kevinsantiagoacosta195/Tesis_FSO/README.md

# Tesis_FSO
sistema de comunicacion FSO (Free Space Optics) para la transmision de Sistemas de alerta temprana, usando paneles solares como fotodetectores, encargador de recibir la señal de comunicacion PWM y la alimentacion del sistema.
 Nota: informacion principal (Bitacora/bitacora.md)
