kevinsantiagoacosta195/Tesis_FSO/Simulaciones/Comparador LM393/Docs/LM393.md

# Simulacion Panel Solar
## Fecha: 15/01/2026
## Objetivo
simular y analizar el comportamiento del comparador LM393, permitiendo analaizar y comprobar su eficiencia para la detencion de pulsos de haz emitido por un laser
## Fundamento teorico
el primer principio teorico es el principio diferencial, su funcionamiento se basa en comparar si la señal de entrada es mas fuerte que el voltaje de referencia establecido en el potenciometro del modulo, del mismo modo esta diseñado para saltar de 0 a 1 permitiendo observar una figura totalmente cuadrada por lo cual no se verian esas "aletas de tiburon que se observaba en el serial plotter del arduino causadas por el rise time tan largo demorandose bastante tanto en subie como en bajr ocacionado por capacitancia o resistencias.

## Metodologia 
1. se Realiza una simulacion por medio de Proteus 8
2. se hace uso de un VPULSE, el cual funciona como la señal esperada por el panel solar
3. se realiza un sistema pasa altos entre un capacitor y una resustencia
4. de la resistencia del capacitor y la resistencia sale hacia el comparador LM393, que ingresa al pin 3.
5. utilizamos un potenciometro como voltaje de referencia
6. se energiza el chip
7. se hace uso de un osciloscopio para analizar las graficas

### Resultado
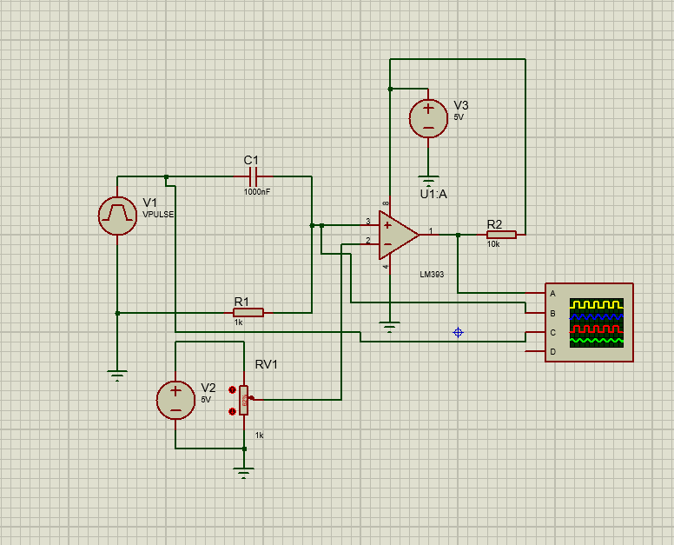
[picture p1: Simulaciones/Comparador LM393/Docs/Imagenes/Circuito comparador LM393.png]
CIRCUITO COMPLETO

se observa el circuito mencionamo anteriormente en la metodologia

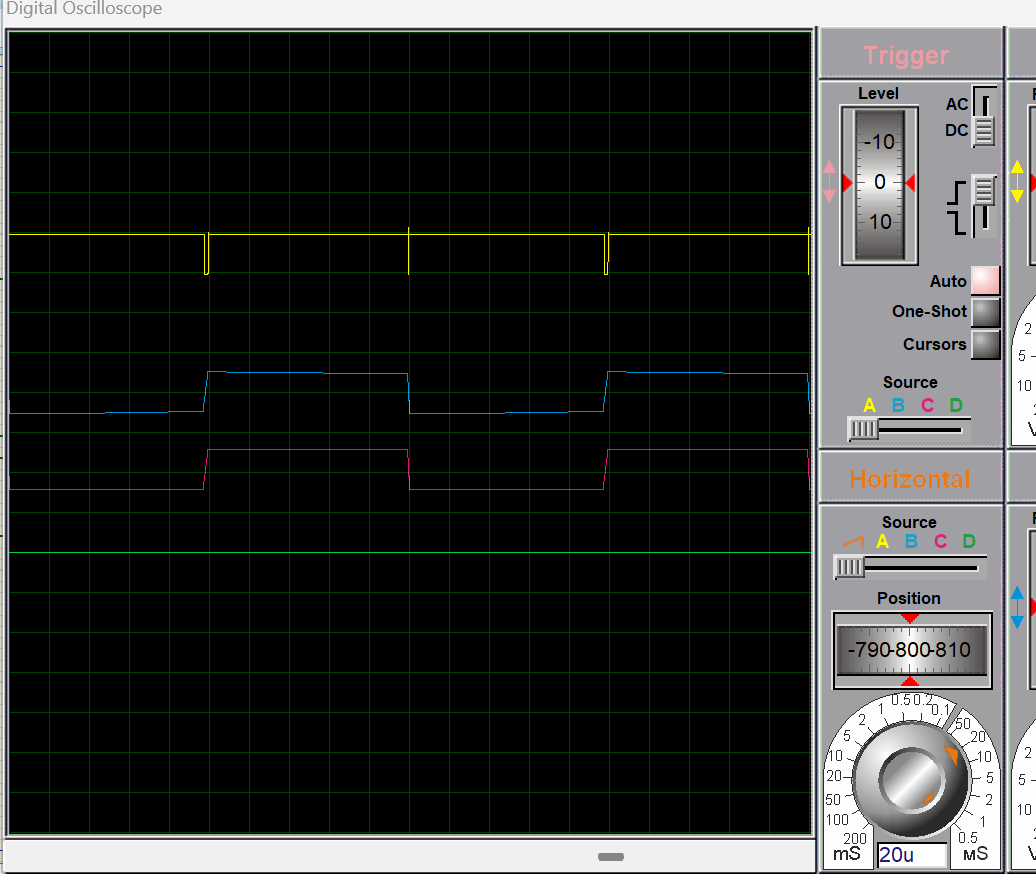
[picture p2: Simulaciones/Comparador LM393/Docs/Imagenes/RESULTADO 1.png]
ANALISIS SEÑAL 1

se observa que presenta aproximadamente el 95% del cycle duty, y unas pequeñas bajadas que son casi similares al Rise Time de la señal del nodo A (filtro pasa-alto), y del VPUlSE

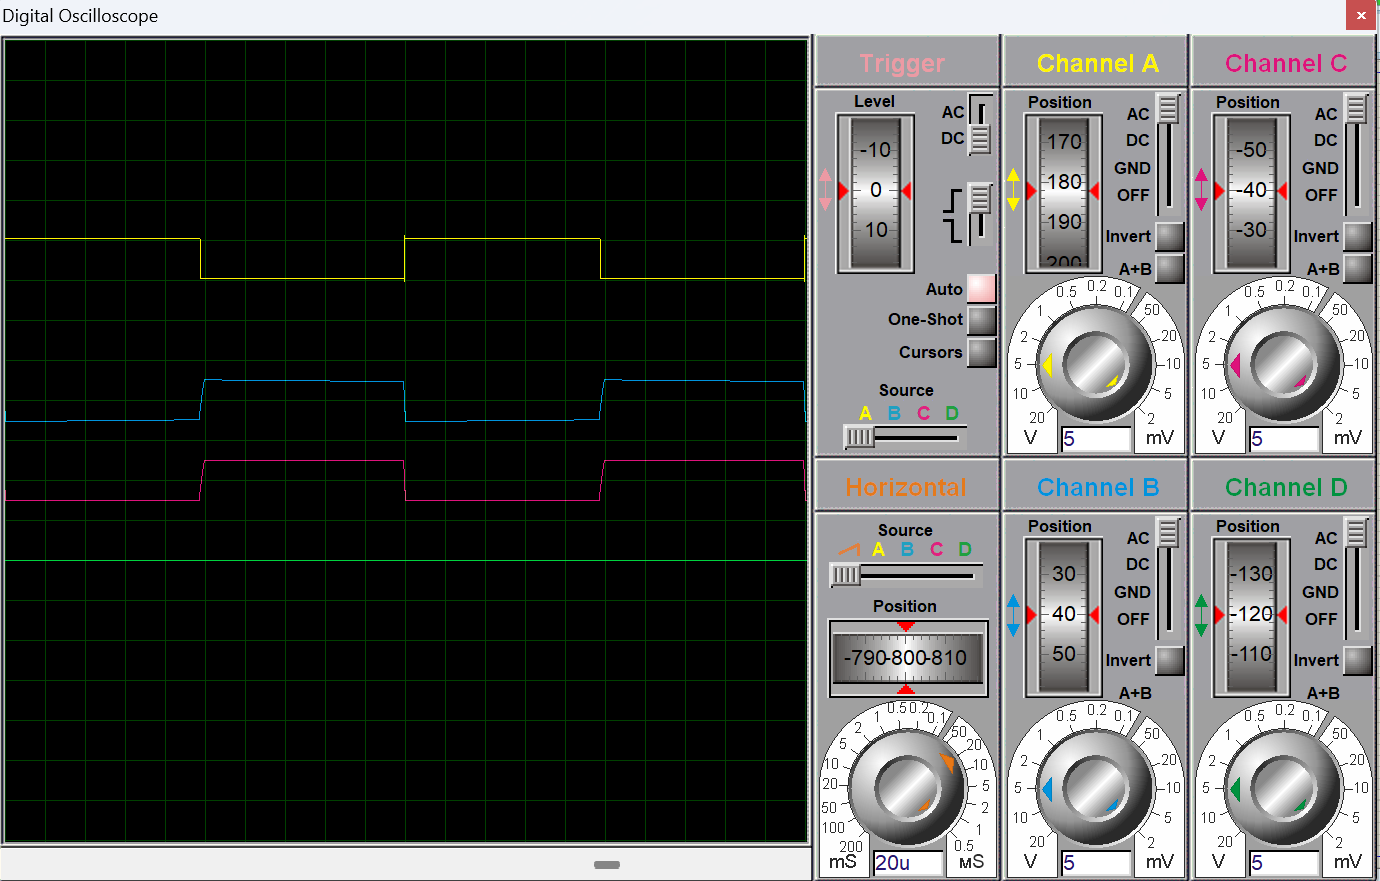
[picture p3: Simulaciones/Comparador LM393/Docs/Imagenes/RESULTADO 2.png]
ANALISIS SEÑAL 2

se observa que presenta el mismo ciclo y como se menciono en el fundamento las señales pwm son mucho mas claras, el arreglo se debo al ajuste del umbral del potenciometro
