kevinsantiagoacosta195/Tesis_FSO/Bitacora/Imagenes Prototipo/09_01_2026/PRUEBA LASER.jpeg

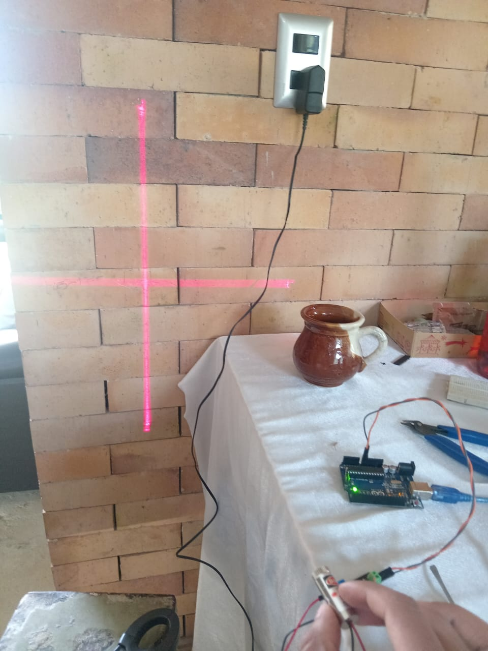
Bitacora/Imagenes Prototipo/09_01_2026/PRUEBA LASER.jpeg
