kevinsantiagoacosta195/Tesis_FSO/Bitacora/Imagenes Prototipo/11_01_2026/CIRCUITO ARREGLADO.jpeg

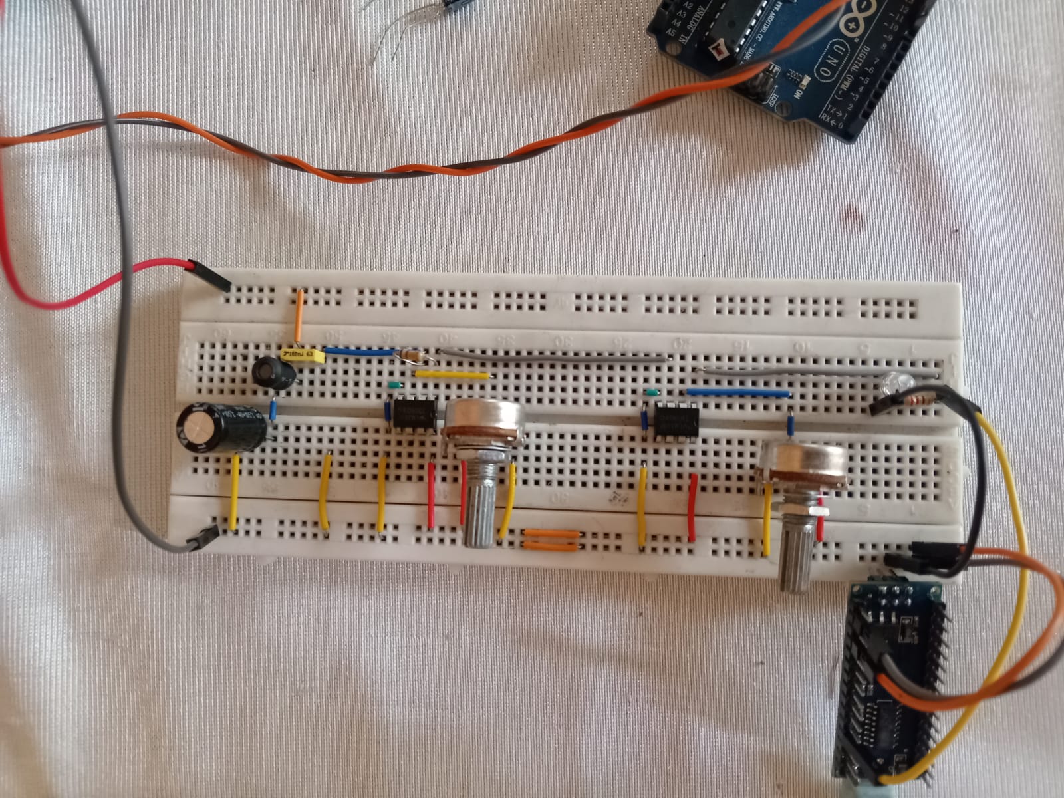
Bitacora/Imagenes Prototipo/11_01_2026/CIRCUITO ARREGLADO.jpeg
