kevinsantiagoacosta195/Tesis_FSO/Bitacora/Imagenes Prototipo/12_01_2026/PANEL SOLAR.jpeg

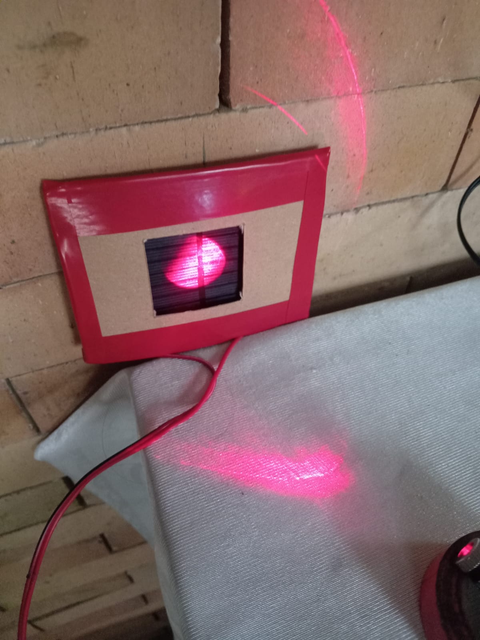
Bitacora/Imagenes Prototipo/12_01_2026/PANEL SOLAR.jpeg
