kevinsantiagoacosta195/Tesis_FSO/Bitacora/Imagenes Prototipo/15_02_2026/Soporte Superior 2.png

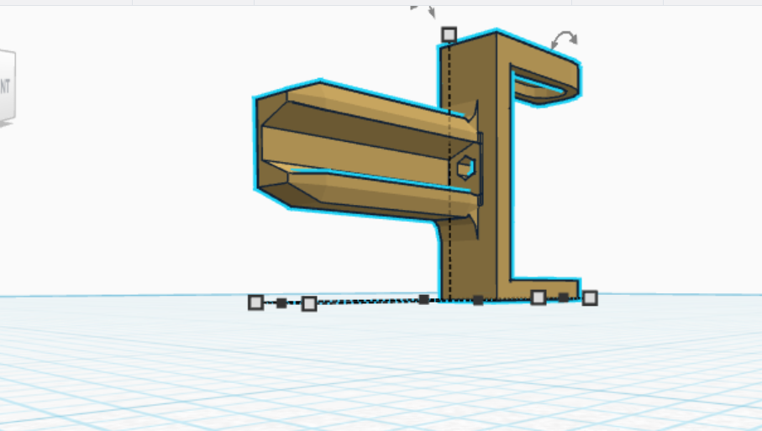
Bitacora/Imagenes Prototipo/15_02_2026/Soporte Superior 2.png
