kevinsantiagoacosta195/Tesis_FSO/(list of files, drawings)

Other design files:
Simulaciones/Bias_T_Filtros/modelo/BIAS_T.pdsprj
Simulaciones/Bias_T_Filtros/modelo/Project Backups/BIAS_T [20260105, 13-15-07].pdsprj
Simulaciones/Bias_T_Filtros/modelo/Project Backups/BIAS_T [20260106, 19-28-16].pdsprj
Simulaciones/Bias_T_Filtros/modelo/Project Backups/BIAS_T [20260107, 13-14-07].pdsprj
Simulaciones/Bias_T_Filtros/modelo/Project Backups/BIAS_T [20260108, 19-27-47].pdsprj
Simulaciones/Bias_T_Filtros/modelo/Project Backups/BIAS_T [20260109, 15-20-34].pdsprj
Simulaciones/Comparador LM393/Modelo/Simulacion LM393.pdsprj
Simulaciones/Pwm_Laser/modelo/Project Backups/PWM_LASER [20251227, 11-21-17].pdsprj
Simulaciones/Pwm_Laser/modelo/Project Backups/PWM_LASER [20251230, 14-53-43].pdsprj
Simulaciones/Pwm_Laser/modelo/PWM_LASER.pdsprj
Simulaciones/Sensores_TX/modelo/PROYECTO SAT FINALIZADO/SENSORES_COMPLETOS.pdsprj
Simulaciones/Sensores_TX/modelo/PRUEBA VINCULO/Project Backups/Vinculo_Arduino_Prueba [20251221, 15-21-21].pdsprj
Simulaciones/Sensores_TX/modelo/PRUEBA VINCULO/Vinculo_Arduino_Prueba.pdsprj
Simulaciones/Sensores_TX/modelo/SENSORE_COMPLETED/BME280/BME280.pdsprj
Simulaciones/Sensores_TX/modelo/SENSORE_COMPLETED/BME280/Project Backups/BME280 [20251223, 14-21-47].pdsprj
Simulaciones/Sensores_TX/modelo/SENSORE_COMPLETED/HCSR04/Sistema_de_sensores_HCSR04.pdsprj
Simulaciones/Sensores_TX/modelo/SENSORE_COMPLETED/MQ-2/Project Backups/Sensores_MQ-2 [20251223, 13-19-10].pdsprj
Simulaciones/Sensores_TX/modelo/SENSORE_COMPLETED/MQ-2/Project Backups/Sensores_MQ-2 [20251223, 13-19-24].pdsprj
Simulaciones/Sensores_TX/modelo/SENSORE_COMPLETED/MQ-2/Sensores_MQ-2.pdsprj
