kevinsantiagoacosta195/Tesis_FSO/(commit log)

2025-12-21 eat(simulaciones): agregar simulación de sensores y vinculación Arduino-Proteus
    se empieza la respectiva simulacion de los sensores del sistema SAT, por medio del software de simulacion de proteus
    [Sensores_MCU_TX.pdsprj]
2025-12-21 Se completa la simulacion realizando un proof of concept (Poc)
    se hizo uso de proof of concept, el cual se uso para validar una idea antes de hacer un sistema mas complejo
    [Vinculo_Arduino_Prueba [20251221, 15-21-21].pdsprj, Vinculo_Arduino_Prueba.pdsprj]
2025-12-21 Se realiza la simulacion del sensor HCSR04
    se realiza la simulacion del sensor HCSR04, que permite medir el nivel del agua, ademas se implementa un sistema de alarma por medio de un LED
2025-12-21 Simulacion MQ-2 en progreso
    Se realiza la simulacion del segundo sensor del sistema SATs
    [Sensores_MQ-2.pdsprj, Sistema_de_sensores_HCSR04.pdsprj]
2025-12-23 Simulacion MQ-2
    se hace uso de un potenciometro cambiando el modulo MQ-2, por mal funcionamiento, realizando asi la respectiva comprobacion del sistema del sensor mq2
2025-12-23 Simulacion BME280
    se procede hacer la simulacion de el sensor BME280, haciendo un enlace entre proteus y arduino
    [BME280.pdsprj, Sensores_MQ-2 [20251223, 13-19-10].pdsprj, Sensores_MQ-2 [20251223, 13-19-24].pdsprj, Sensores_MQ-2.pdsprj]
2025-12-23 Inicio simulacion completa sensores por medio de Proteus 8
    [BME280 [20251223, 14-21-47].pdsprj, BME280.pdsprj, SENSORES_COMPLETOS.pdsprj]
2025-12-24 se completa simulacion sensores SATs
2025-12-24 Se realizaron las respectivas Correciones y recomendaciones de la simulacion de SATs
2025-12-24 Simulacion PWM, Laser proteus
    [Nuevo proyecto.pdsprj]
2025-12-26 Simulacion PWM
    se realiza un circuito reresentando una modulacion PWM, igual se realiza la interpretacion de un laser por medio de un laser, observando la manera en que camia la potencia optica, del mismo modo se hace analisis de sus graficas y de sus voltajes y corrientes
    [Nuevo proyecto.pdsprj, PWM_LASER.pdsprj]
2025-12-30 Simulacion PWM_LASER MOSFET
    [PWM_LASER [20251227, 11-21-17].pdsprj, PWM_LASER.pdsprj, tabla_resultados_pwm.csv]
2025-12-30 Update PWM_LASER [Autosaved].pdsprj
2025-12-30 Finalizacion de la simulacion PWM_LASER
    Se realiza el cambio de circuito pasando de un transistor BJT a un MOSFET, ya que gracias a su funcionamiento permite un funcionamiento mas eficaz, ademas de un DSP, para comprender de manera optima el sistema transmisor, completando asi, en TX, ahora se prosigue con la simulacion del canal FSO
    [tabla_resultados_pwm.csv]
2025-12-30 Conclusion de pwm_Laser
2026-01-03 Simulacion del canal FSO
    [PWM_LASER [20251230, 14-53-43].pdsprj, PWM_LASER.pdsprj]
2026-01-03 Simulacion de Panel solar
2026-01-05 Simulacion Bias_T
    [BIAS_T [20260105, 13-15-07].pdsprj, BIAS_T.pdsprj]
2026-01-09 Simulacion Bias tee
    [BIAS_T [20260106, 19-28-16].pdsprj, BIAS_T [20260107, 13-14-07].pdsprj, BIAS_T.pdsprj]
2026-01-09 etapa de prototipado
    [BIAS_T [20260108, 19-27-47].pdsprj, BIAS_T [20260109, 15-20-34].pdsprj, BIAS_T.pdsprj]
2026-01-14 Circuito Pasa alto
2026-01-15 Simulacion LM393
    [Simulacion LM393.pdsprj]
2026-03-16 Servos PAN-TILT
2026-03-16 Diseño hardware dedicado (PCB
2026-03-16 Finalidad de Diseño V1
2026-03-17 Desarrollo de hadware segunda version
2026-03-17 Aclaracion de futuras Decisiones
